dotMR/LugeRacerTimer/docs/arduino-top.JPG

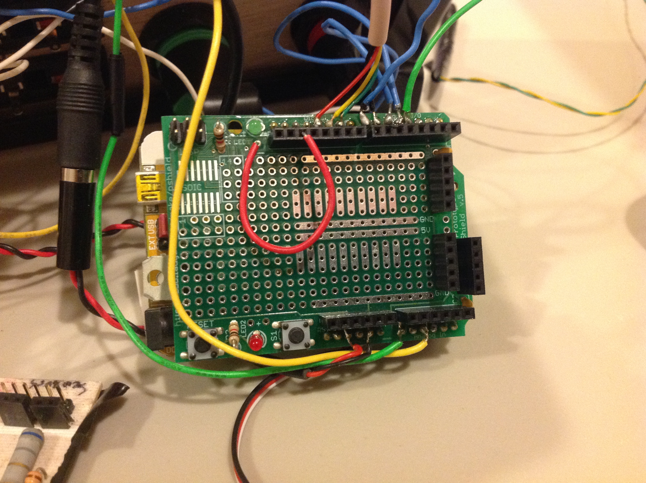
docs/arduino-top.JPG
