dotMR/LugeRacerTimer/docs/xmas-tree-distro.JPG

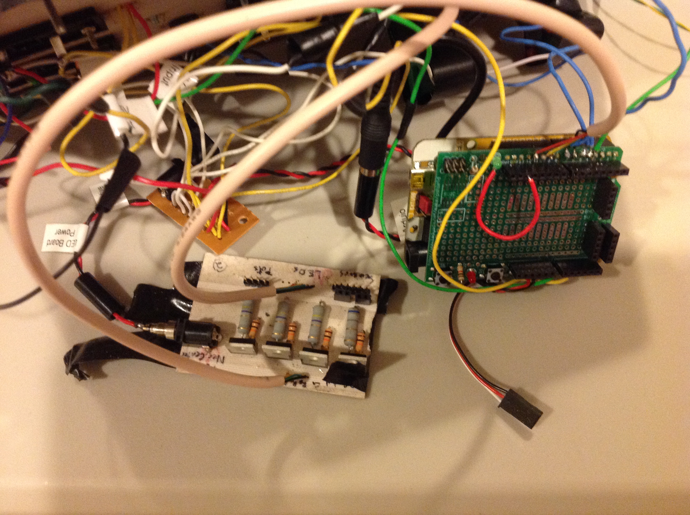
docs/xmas-tree-distro.JPG
