dotMR/LugeRacerTimer/README.md

LugeTimer
=====

Arduino based timing system for backayard luge racing.

More information on the timing system can be found here:
http://www.ssbla.org/tech/
