dotMR/LugeRacerTimer/docs/power-distro.JPG

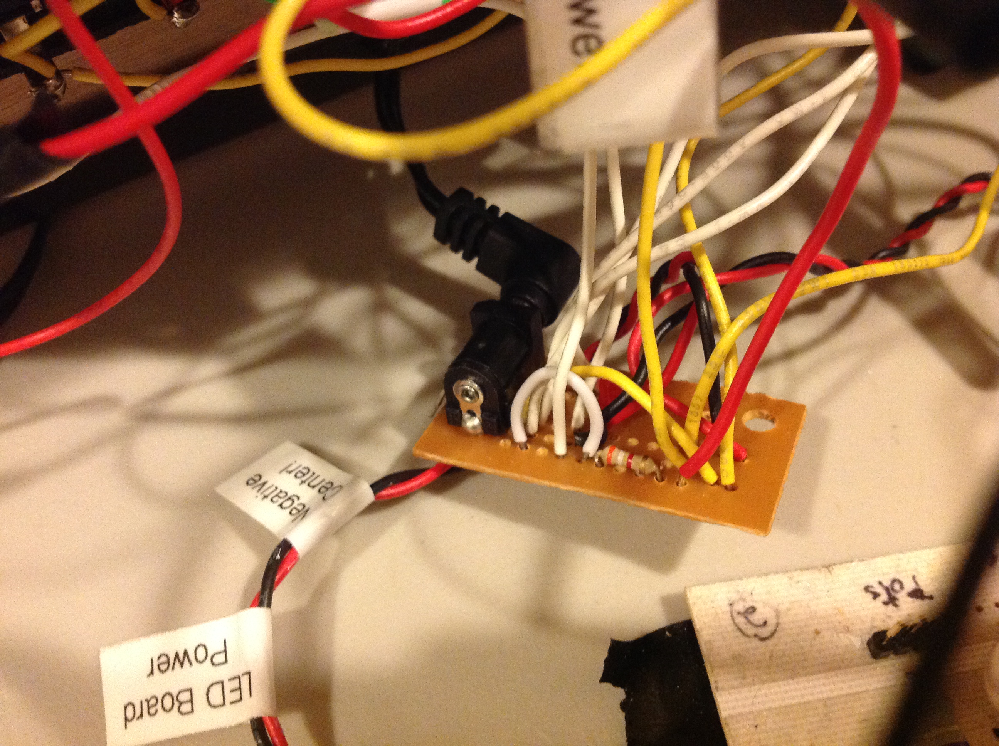
docs/power-distro.JPG
