dotMR/LugeRacerTimer/docs/timer-face.JPG

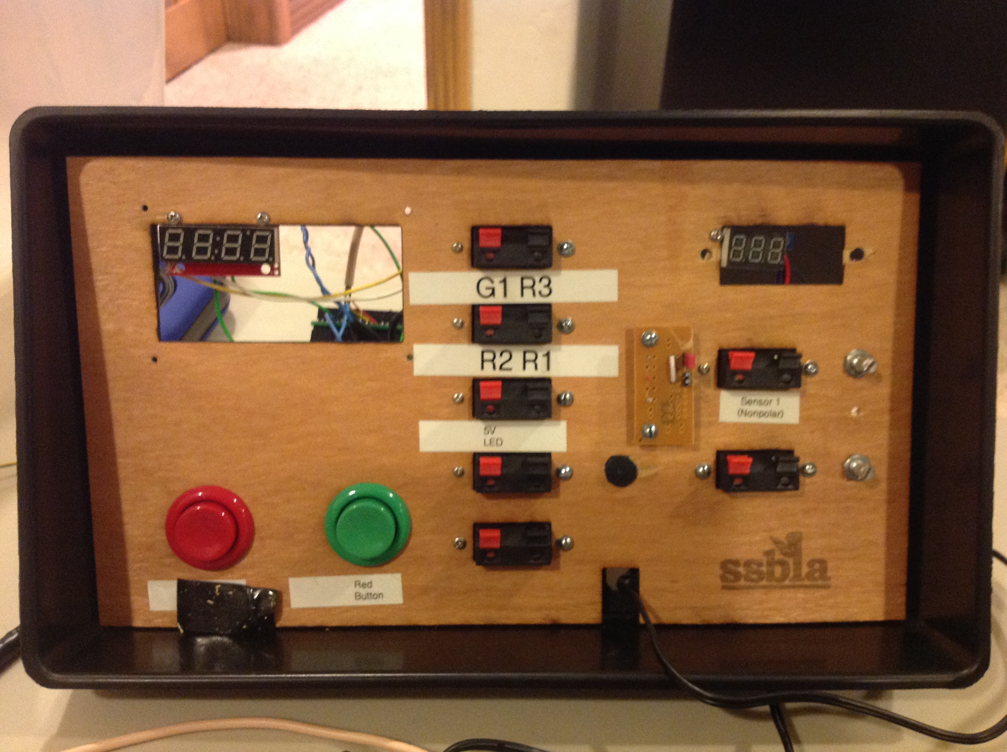
docs/timer-face.JPG
