dotMR/LugeRacerTimer/docs/timer-inside.JPG

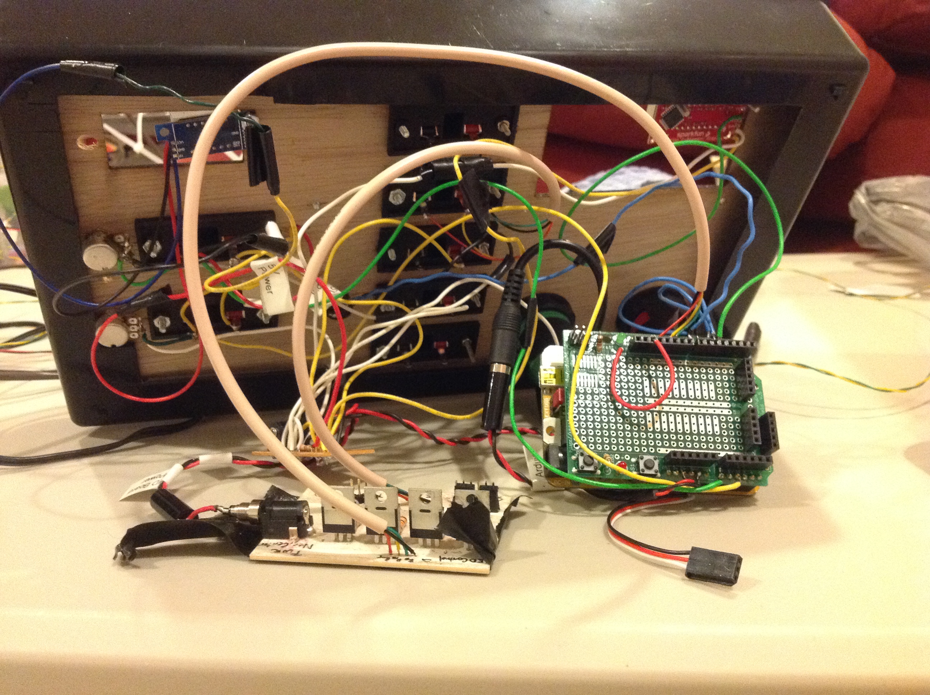
docs/timer-inside.JPG
