dotMR/LugeRacerTimer/docs/parts.md

####PARTS
|name|use|qty|misc|
|:----|:---:|:---:|:---:|
|Ammo dry box|case|1||
|Arduino Due board||1||
|Serial 7-segment display|ui/output|1||
|Voltage Meter|sensor calibration|2||
|Pots (10k ohm)|sensor calibration|2||
|Buzzer (piezo, 95dB)|annoyance|1||
|[Arcade Button (green)](https://www.sparkfun.com/products/9341)||1||
|[Arcade Button (red)](https://www.sparkfun.com/products/9336)||1||
|Speaker wire spring terminals||5||
|Barrel Jack (power distro, xmas tree supply)||2||
|Resistor (power distro)|? Ohm|1||
|Big Resistor (xmas tree)|? Ohm|4||
|Small Resistor (xmas tree)|? Ohm|4||
|Transistor (xmas tree)|? Model|4||
|[High-power LED (green)](https://www.sparkfun.com/products/retired/9636)|go!|1||
|[High-power LED (red)](https://www.sparkfun.com/products/retired/9634)||3||
|CdS photo sensor|finish line sensors|2||
