dotMR/LugeRacerTimer/(threads)

Thread 1 (2015-01-13):

Replace broken red xmas tree light

dotMR, 2015-01-13:

jqpubliq, 2015-01-13:
Another idea: addressable RGB LED strip on a pole.  Not sure whether it'd be bright enough during the day, but if you got a 1-2 meter strip and grouped the LEDs together (e.g., a foot of red, another foot of red, another foot of red, a foot of green) or flashed the entire strip one color (all red, off, all red, off, all red, off, all green, off, all blink).

Thread 2 (2015-01-13):

Add knobs to potentiometers

dotMR, 2015-01-13:
Purchase knobs to fit the sensor calibration pots

jqpubliq, 2015-01-13:
Getting these: https://www.sparkfun.com/products/11950
and these: https://www.sparkfun.com/products/11949

Thread 3 (2015-01-13):

Wire up voltmeter to pots for second sensor

dotMR, 2015-01-13:
Do we need another voltmeter?

jqpubliq, 2015-01-13:
I have another voltmeter.  I bought two in the first instance.  It's here with me (in my briefcase right now, actually) so I can measure it up for the faceplate.  I don't have a spec sheet for it.

Thread 4 (2015-01-13):

Laser cut new top for timer box

dotMR, 2015-01-13:
Ryan has a new design in mind
- smaller opening for 7-segment display rather than previous LCD
- 2 voltmeter openings (one for each finish-line sensor)

ssbla, 2015-01-14:
Most current version from Ryan:
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

Closed 2020-12-22.

Thread 5 (2015-01-13):

Add ability to reset while timer is running

dotMR, 2015-01-13:

Thread 12 (2015-01-27):

Footage next year

dotMR, 2015-01-27:
Need to fully capture (video) of timing system in action
- start lights, usage of main box, sensor tripping, etc.

Of track:
- Better drone footage overhead
- Timelapse of track being dug
- Full timelapse of race (need good low-light camera setup)

Of racers:
Hang 2 GoPros from cable-cam? So we capture racer coming and going?

dotMR, 2015-02-18:
Track build footage using some sort of super-slow moving timelapse
https://syrp.co.nz/community/tutorials/diy-cable-cam-tutorial

Thread 14 (2015-02-28):

Digital Pot for sensor calibration?

dotMR, 2015-02-28:
Could we use one to auto-calibrate the sensors around 2.5V?

http://makezine.com/projects/make-43/digital-potentiometers/

dotMR, 2015-03-15:
I'm going to order one of these to play around with:
https://www.tinkersoup.de/en/components/potentiometer/digital-potentiometer-10k/a-792/

Thread 16 (2015-03-01):

Single board: why do buzzers just click now?

dotMR, 2015-03-01:

jqpubliq, 2015-03-01:
I wonder whether a 3:8 decoder would be faster than a shift register.
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

dotMR, 2015-03-01:
Re: buzzer, Ryan says:
"The buzzer needs to be driven with a square wave. I'm not sure how fast the register can clock in data, but you might be able to drive the buzzer off the register pin if it's fast enough."

btw, the volume is also really low on the buzzer. And it happens on the main board buzzer as well, which makes me think it's more specific to the buzzers I got than the shift register.

dotMR, 2015-03-01:
Re: decoder
Not sure about the decoder - I would guess it would be faster though as less serial bit banging.

dotMR, 2015-03-01:
woops:
Looks like we need to supply the +5V @ 2048Hz for speaker output.

"Sound output Min. 85 (Typical 95) dBA Distance at 10cm (A-weight free air).
Applying rated voltage of 2048 Hz, square
wave, 1/2 duty."
http://dlnmh9ip6v2uc.cloudfront.net/datasheets/Components/General/cem-1203-42-.pdf

jqpubliq, 2015-03-01:
Isn't this what we did for the other buzzer?

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

dotMR, 2015-03-02:
decoder conversation moved to new issue #17

Yeah, we did something similar with the other buzzing, but i'm using the same code. [~Line 509](https://github.com/dotMR/LugeRacerTimer/blob/shift/src/LugeRacerTimer.ino#L509)

Looks like buzzers I bought here are Sparkfun parts, so we'd likely run into the same issue with any others we'll order in the future.

I'll try the tone library and see if anything changes.

dotMR, 2015-03-04:
Fixed in my current 'shift' branch 71fe012126ceeb9e40535c947589b4647b63c7d0

jqpubliq, 2015-03-04:
So it's working through the shift register now?  Sweet.

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

Closed 2015-03-04.

Thread 18 (2015-03-04):

Sometimes trap sensor is triggered with nothing connected

dotMR, 2015-03-04:
Which results in an inaccurate speed displaying when there should be none.

I've only seen this issue on my breadboard timer. Nothing is hooked up to the analog input pin for the trap sensor (no photocell, pot voltage divider, etc)

dotMR, 2015-03-15:
I probably just need to set a pull-up resistor for the pin, but I wonder why I'm seeing this now when we didn't see it in other testing when there was no sensor connected? Maybe because everything was still grounded appropriately from the board perspective?
