dotMR/LugeRacerTimer/(commit log)

2013-01-13 changing name of main file so Arduino software doesn't complain
    [LugeRacerTimer.ino]
2013-01-14 updating logic for capturing speed. Value displays currently, but sample count doesn't seem correct
    [LugeRacerTimer.ino]
2013-01-14 fixed sample discrepancy, prettified display of speed and time
    [LugeRacerTimer.ino]
2013-01-15 updating sensor distance constant to match track
2013-01-15 updating Serial print speed and removing debug prints
2015-01-03 removed push-button diagnostic mode with voltage readings and implemented basic light and buzzer test on startup
    [DisplayMethods.ino, LugeRacerTimer.ino]
2015-01-03 Added running timer (fixed bug where it stopped at ~5 seconds), code cleanup
    [DisplayMethods.ino, LugeRacerTimer.ino]
2015-01-14 restruction of directory, added photos of timer
2015-03-15 updated TODO regarding code transfer to timer
